Luckst4r/OpenSourcedMiners/LuckyMinerLV08/BM1366_mode1_sheet_1.kicad_sch

## KiCad design LuckyMinerLV08/BM1366_mode1_sheet_1.kicad_sch (2025-10-28)

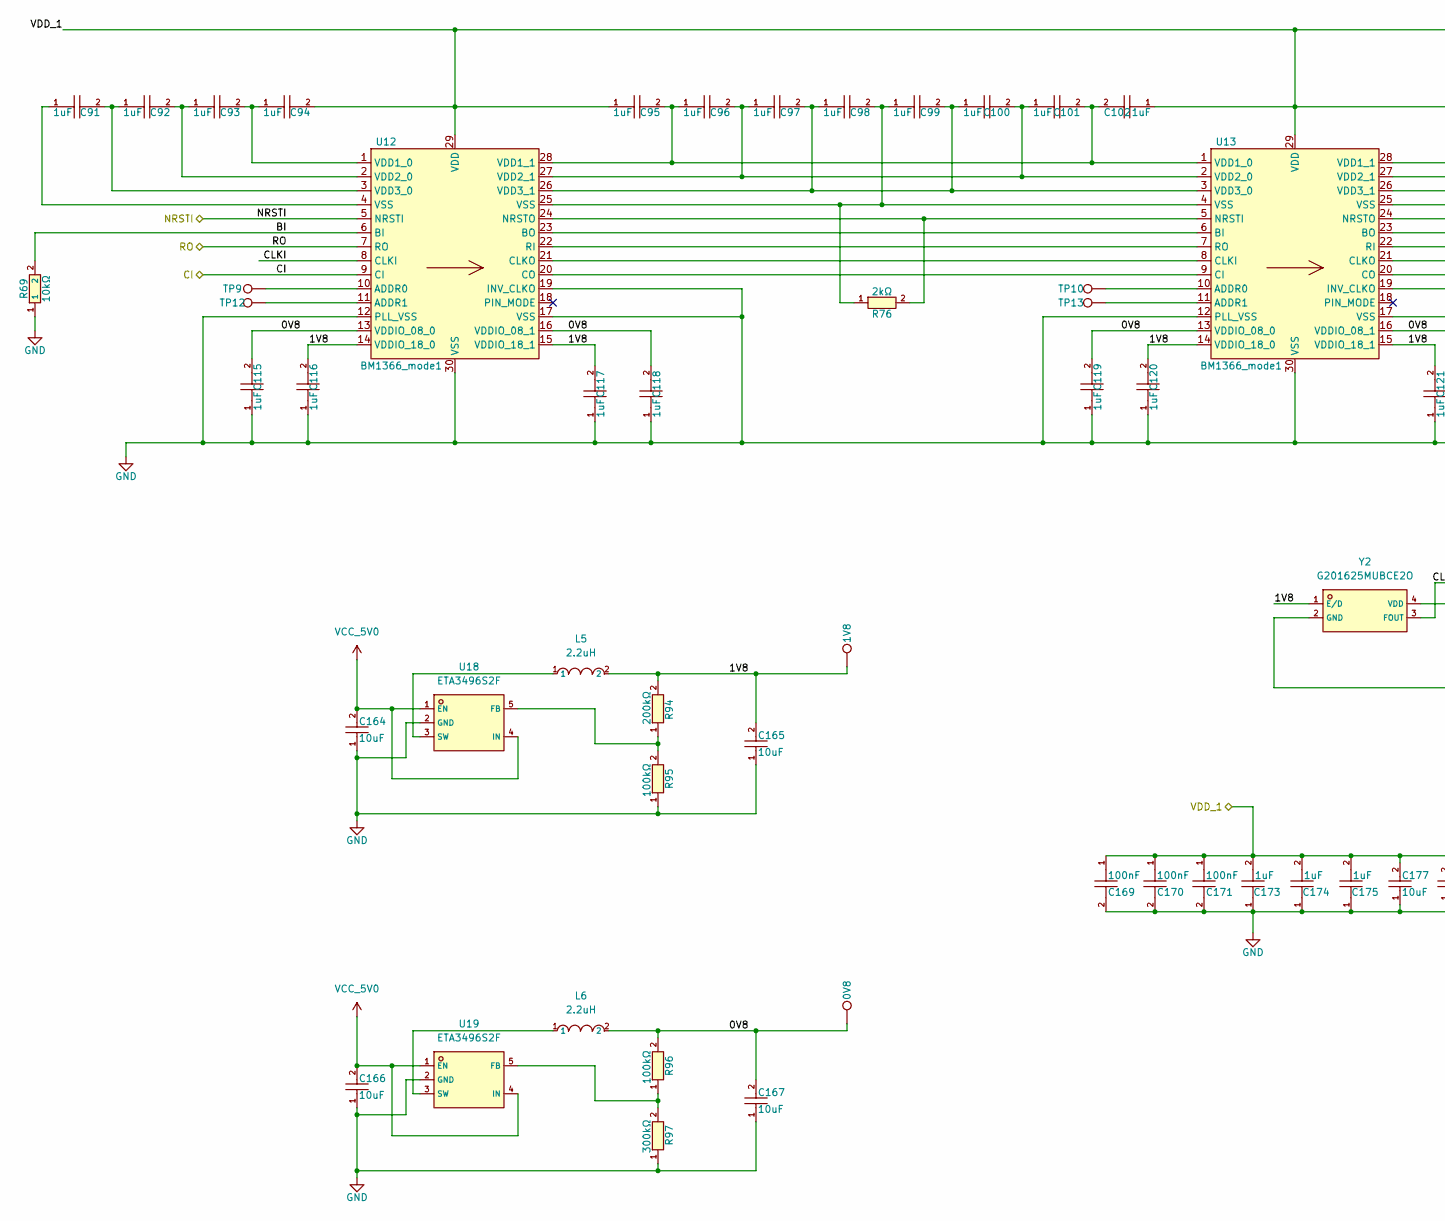
[picture p1: schematic BM1366_mode1_sheet_1.kicad_sch, part in row 1, column 1]

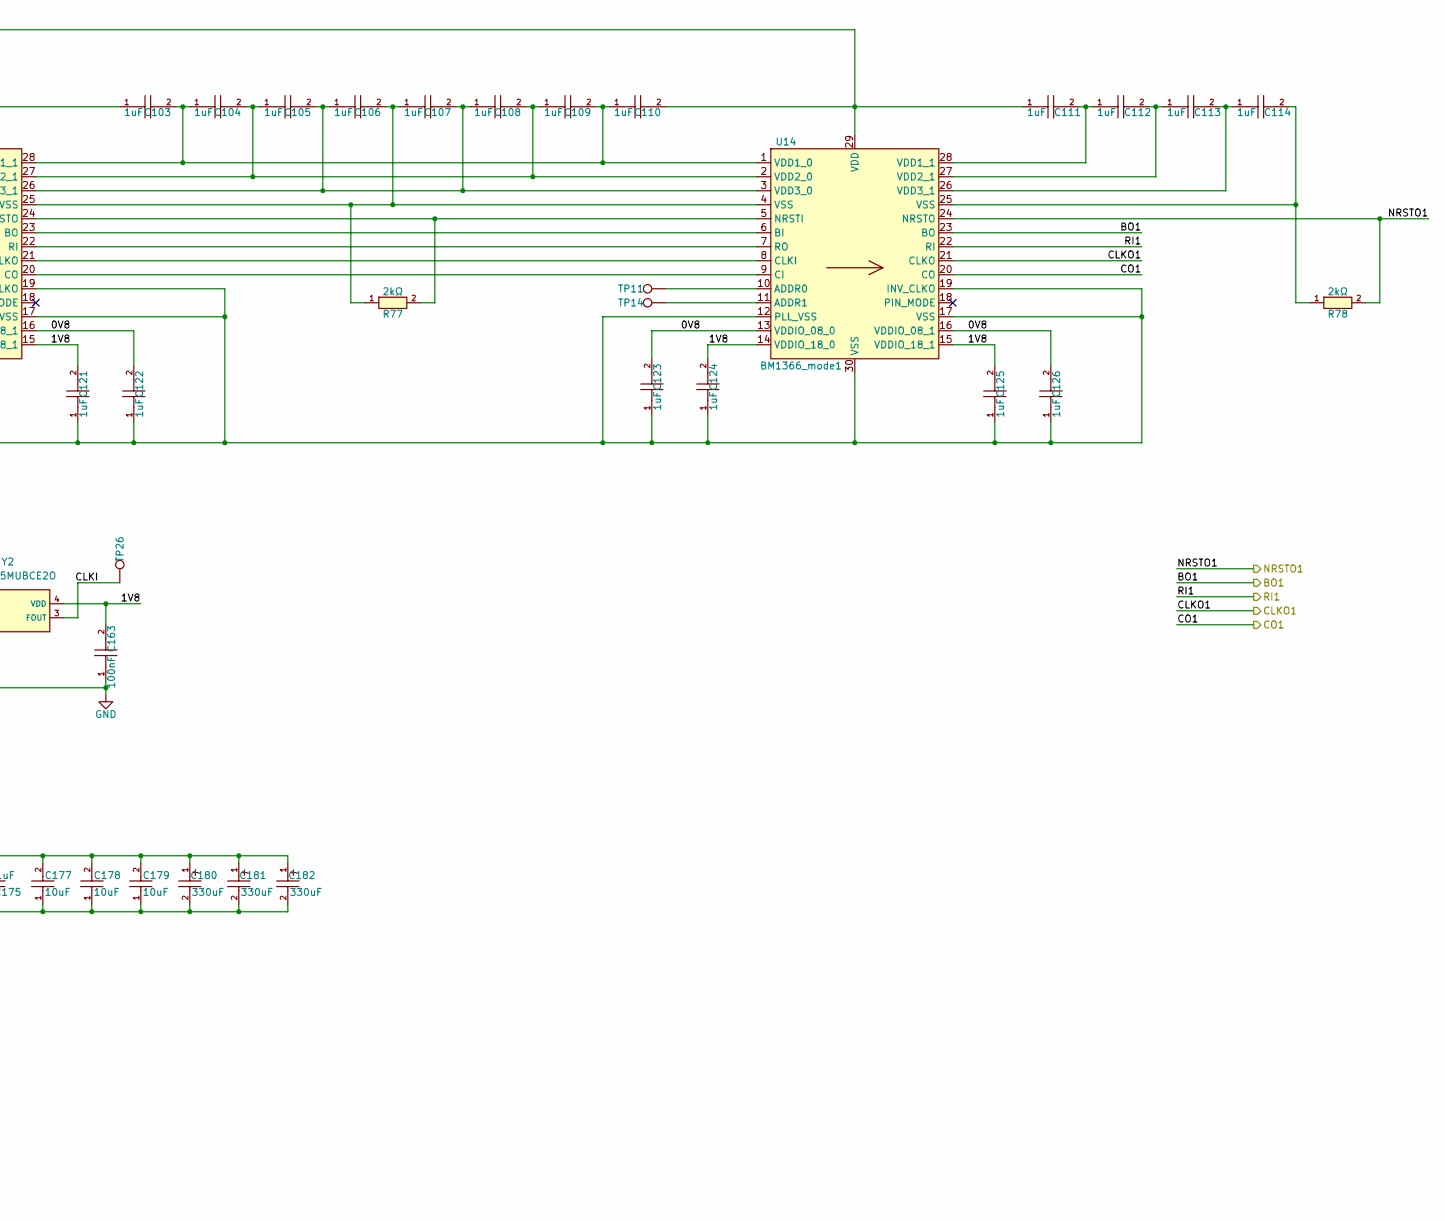
[picture p2: schematic BM1366_mode1_sheet_1.kicad_sch, part in row 1, column 2]

Parts:
0V8, 1V8: TestPoint; TestPoint_Pad_D1.0mm
C91, C92, C93, C94, C95, C96, C97, C98, C99, C100, C101, C102, C103, C104, C105, C106, C107, C108, C109, C110, C111, C112, C113, C114, C115, C116, C117, C118, C119, C120, C121, C122, C123, C124, C125, C126, C173, C174, C175: 1uF; C0402; LCSC C52923
C163, C169, C170, C171: 100nF; C0402; LCSC C307331
C164, C165, C166, C167, C177, C178, C179: 10uF; C0402; LCSC C15525
C180, C181, C182: 330uF; CASE-D_7343; LCSC C7226
L5, L6: 2.2uH; L0805; LCSC C1043
R69: 10kΩ; R0402; LCSC C25744
R76, R77, R78: 2kΩ; R0402; LCSC C4109
R94: 200kΩ; R0402; LCSC C25764
R95, R96: 100kΩ; R0402; LCSC C25741
R97: 300kΩ; R0402; LCSC C25774
TP9, TP10, TP11, TP12, TP13, TP14, TP26: TestPoint; TestPoint_Pad_D1.0mm
U12, U13, U14: BM1366_mode1; BM1366
U18, U19: ETA3496S2F; SOT-23-5_L2.9-W1.6-P0.95-LS2.8-BR; LCSC C7465505
Y2: G201625MUBCE2O; CRYSTAL-SMD_4P-L2.0-W1.6-BL-1; LCSC C41399445

Connections:
0V8: 0V8.1, C115.2, C118.2, C119.2, C122.2, C123.2, C126.2, C167.2, L6.2, R96.2, U12.13 (VDDIO_08_0), U12.16 (VDDIO_08_1), U13.13 (VDDIO_08_0), U13.16 (VDDIO_08_1), U14.13 (VDDIO_08_0), U14.16 (VDDIO_08_1)
1V8: 1V8.1, C116.2, C117.2, C120.2, C121.2, C124.2, C125.2, C163.2, C165.2, L5.2, R94.2, U12.14 (VDDIO_18_0), U12.15 (VDDIO_18_1), U13.14 (VDDIO_18_0), U13.15 (VDDIO_18_1), U14.14 (VDDIO_18_0), U14.15 (VDDIO_18_1), Y2.1 (E/D), Y2.4 (VDD)
BI: R69.2, U12.6 (BI)
BO1: U14.23 (BO)
CI: U12.9 (CI)
CLKI: TP26.1, U12.8 (CLKI), Y2.3 (FOUT)
CLKO1: U14.21 (CLKO)
CO1: U14.20 (CO)
GND: C115.1, C116.1, C117.1, C118.1, C119.1, C120.1, C121.1, C122.1, C123.1, C124.1, C125.1, C126.1, C163.1, C164.1, C165.1, C166.1, C167.1, C169.2, C170.2, C171.2, C173.1, C174.1, C175.1, C177.1, C178.1, C179.1, C180.2, C181.2, C182.2, R69.1, R95.1, R97.1, U12.12 (PLL_VSS), U12.17 (VSS), U12.19 (INV_CLKO), U12.30 (VSS), U13.12 (PLL_VSS), U13.17 (VSS), U13.19 (INV_CLKO), U13.30 (VSS), U14.12 (PLL_VSS), U14.17 (VSS), U14.19 (INV_CLKO), U14.30 (VSS), U18.2 (GND), U19.2 (GND), Y2.2 (GND)
NRSTI: U12.5 (NRSTI)
NRSTO1: R78.2, U14.24 (NRSTO)
unnamed: C91.1, U12.4 (VSS)
unnamed: C91.2, C92.1, U12.3 (VDD3_0)
unnamed: C92.2, C93.1, U12.2 (VDD2_0)
unnamed: C93.2, C94.1, U12.1 (VDD1_0)
unnamed: C98.2, C99.1, R76.1, U12.25 (VSS), U13.4 (VSS)
unnamed: C97.2, C98.1, C99.2, C100.1, U12.26 (VDD3_1), U13.3 (VDD3_0)
unnamed: C96.2, C97.1, C100.2, C101.1, U12.27 (VDD2_1), U13.2 (VDD2_0)
unnamed: C95.2, C96.1, C101.2, C102.2, U12.28 (VDD1_1), U13.1 (VDD1_0)
unnamed: C103.2, C104.1, C109.2, C110.1, U13.28 (VDD1_1), U14.1 (VDD1_0)
unnamed: C104.2, C105.1, C108.2, C109.1, U13.27 (VDD2_1), U14.2 (VDD2_0)
unnamed: C105.2, C106.1, C107.2, C108.1, U13.26 (VDD3_1), U14.3 (VDD3_0)
unnamed: C106.2, C107.1, R77.1, U13.25 (VSS), U14.4 (VSS)
unnamed: C111.2, C112.1, U14.28 (VDD1_1)
unnamed: C112.2, C113.1, U14.27 (VDD2_1)
unnamed: C113.2, C114.1, U14.26 (VDD3_1)
unnamed: C114.2, R78.1, U14.25 (VSS)
unnamed: L5.1, U18.3 (SW)
unnamed: L6.1, U19.3 (SW)
unnamed: R76.2, U12.24 (NRSTO), U13.5 (NRSTI)
unnamed: R77.2, U13.24 (NRSTO), U14.5 (NRSTI)
unnamed: R94.1, R95.2, U18.5 (FB)
unnamed: R96.1, R97.2, U19.5 (FB)
unnamed: TP9.1, U12.10 (ADDR0)
unnamed: TP10.1, U13.10 (ADDR0)
unnamed: TP11.1, U14.10 (ADDR0)
unnamed: TP12.1, U12.11 (ADDR1)
unnamed: TP13.1, U13.11 (ADDR1)
unnamed: TP14.1, U14.11 (ADDR1)
unnamed: U12.20 (CO), U13.9 (CI)
unnamed: U12.21 (CLKO), U13.8 (CLKI)
unnamed: U12.22 (RI), U13.7 (RO)
unnamed: U12.23 (BO), U13.6 (BI)
unnamed: U13.20 (CO), U14.9 (CI)
unnamed: U13.21 (CLKO), U14.8 (CLKI)
unnamed: U13.22 (RI), U14.7 (RO)
unnamed: U13.23 (BO), U14.6 (BI)
RI1: U14.22 (RI)
RO: U12.7 (RO)
VCC_5V0: C164.2, C166.2, U18.1 (EN), U18.4 (IN), U19.1 (EN), U19.4 (IN)
VDD_1: C94.2, C95.1, C102.1, C103.1, C110.2, C111.1, C169.1, C170.1, C171.1, C173.2, C174.2, C175.2, C177.2, C178.2, C179.2, C180.1, C181.1, C182.1, U12.29 (VDD), U13.29 (VDD), U14.29 (VDD)
