Luckst4r/OpenSourcedMiners/LuckyMinerLV08/BM1366_mode1_sheet_2.kicad_sch

## KiCad design LuckyMinerLV08/BM1366_mode1_sheet_2.kicad_sch (2025-10-28)

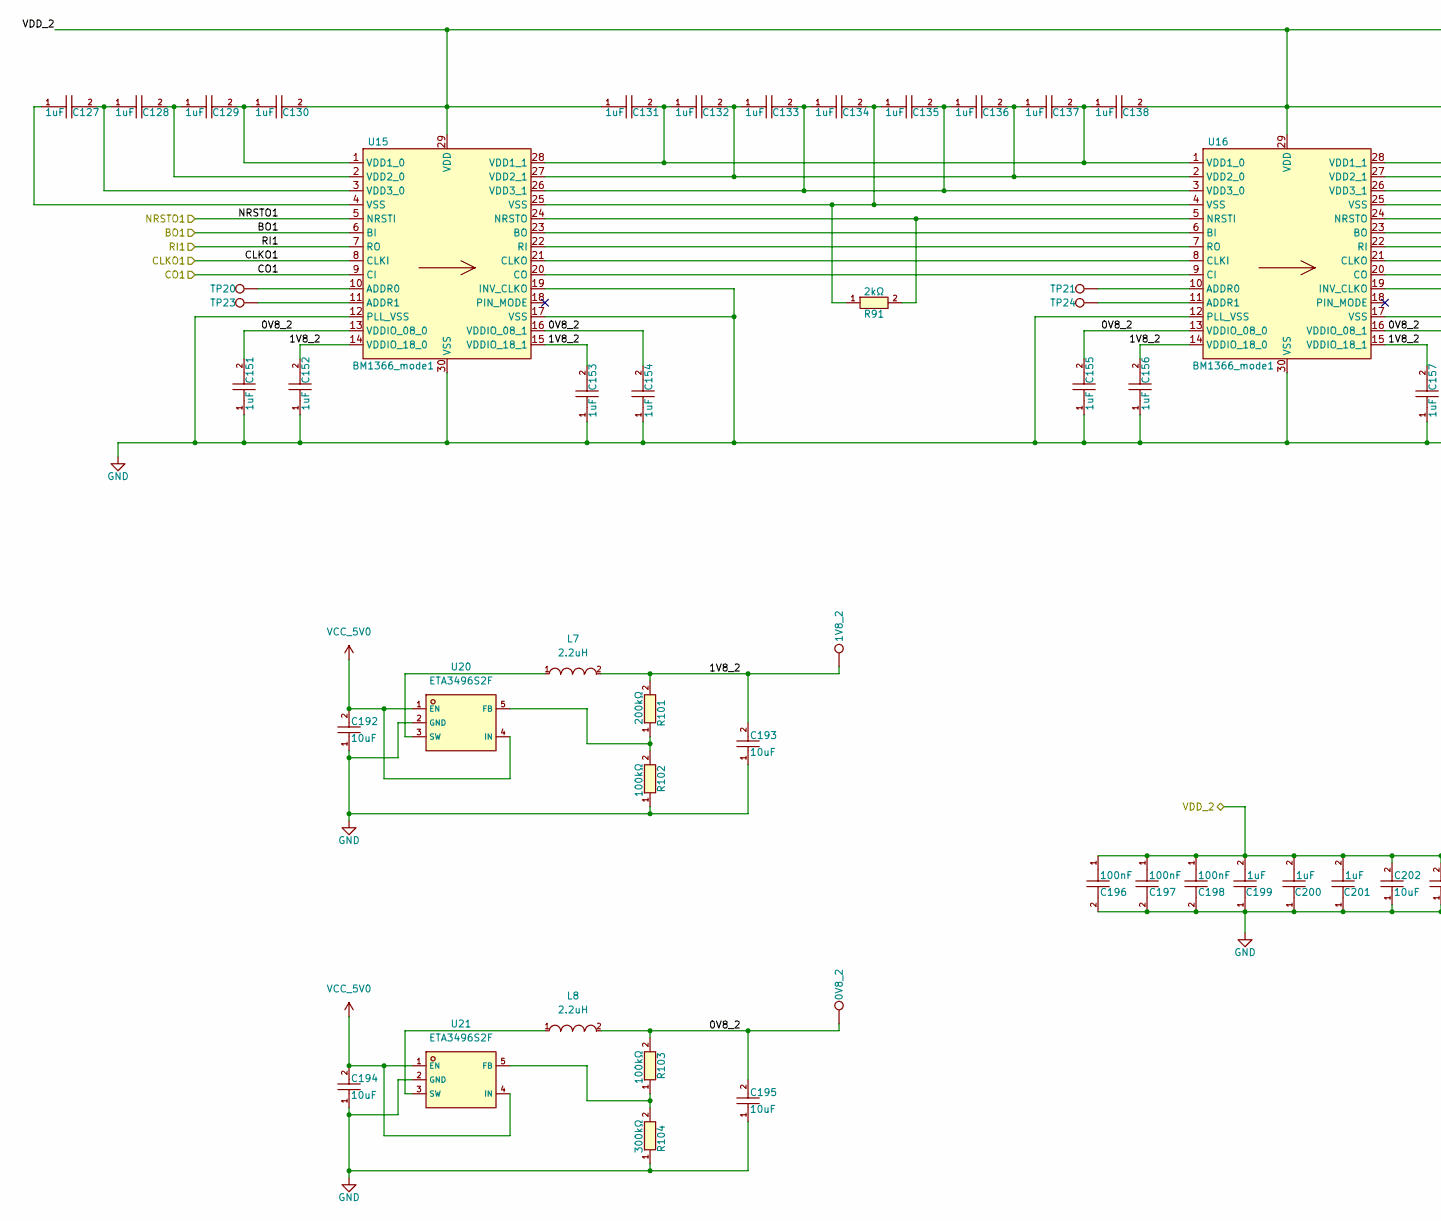
[picture p3: schematic BM1366_mode1_sheet_2.kicad_sch, part in row 1, column 1]

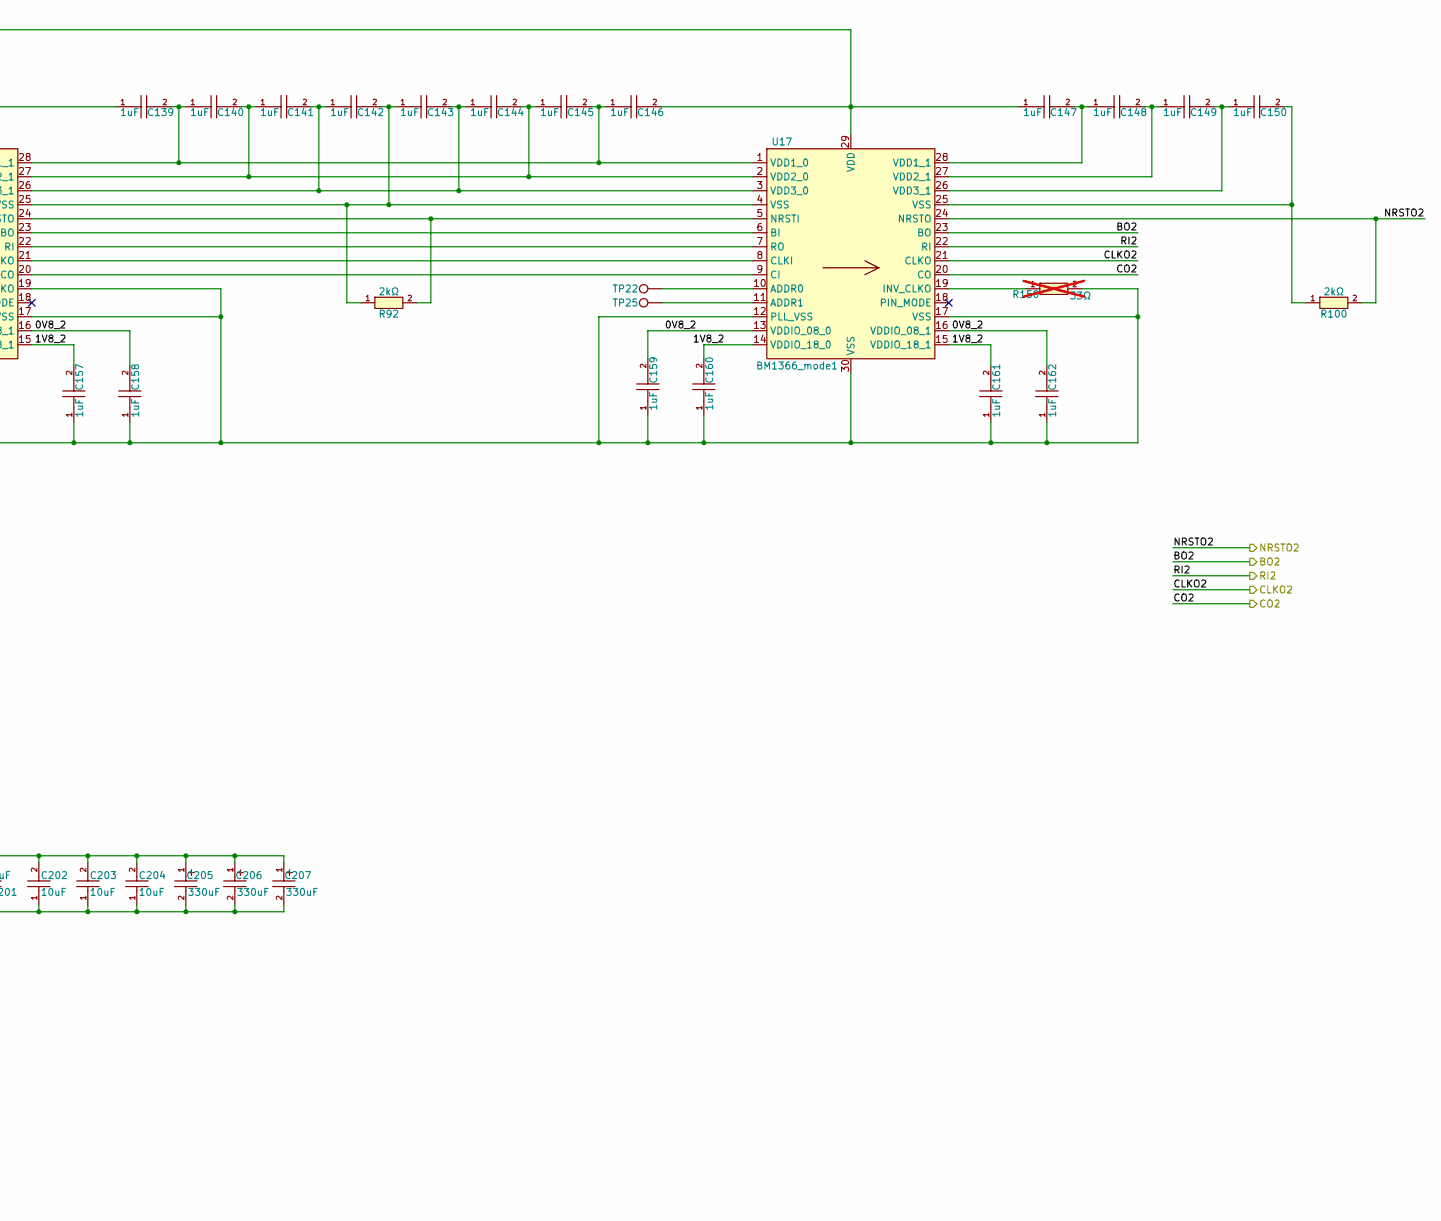
[picture p4: schematic BM1366_mode1_sheet_2.kicad_sch, part in row 1, column 2]

Parts:
0V8_2, 1V8_2: TestPoint; TestPoint_Pad_D1.0mm
C127, C128, C129, C130, C131, C132, C133, C134, C135, C136, C137, C138, C139, C140, C141, C142, C143, C144, C145, C146, C147, C148, C149, C150, C151, C152, C153, C154, C155, C156, C157, C158, C159, C160, C161, C162, C199, C200, C201: 1uF; C0402; LCSC C52923
C192, C193, C194, C195, C202, C203, C204: 10uF; C0402; LCSC C15525
C196, C197, C198: 100nF; C0402; LCSC C307331
C205, C206, C207: 330uF; CASE-D_7343; LCSC C7226
L7, L8: 2.2uH; L0805; LCSC C1043
R91, R92, R100: 2kΩ; R0402; LCSC C4109
R101: 200kΩ; R0402; LCSC C25764
R102, R103: 100kΩ; R0402; LCSC C25741
R104: 300kΩ; R0402; LCSC C25774
R150: 33Ω; R0402; LCSC C25105; not fitted
TP20, TP21, TP22, TP23, TP24, TP25: TestPoint; TestPoint_Pad_D1.0mm
U15, U16, U17: BM1366_mode1; BM1366
U20, U21: ETA3496S2F; SOT-23-5_L2.9-W1.6-P0.95-LS2.8-BR; LCSC C7465505

Connections:
0V8_2: 0V8_2.1, C151.2, C154.2, C155.2, C158.2, C159.2, C162.2, C195.2, L8.2, R103.2, U15.13 (VDDIO_08_0), U15.16 (VDDIO_08_1), U16.13 (VDDIO_08_0), U16.16 (VDDIO_08_1), U17.13 (VDDIO_08_0), U17.16 (VDDIO_08_1)
1V8_2: 1V8_2.1, C152.2, C153.2, C156.2, C157.2, C160.2, C161.2, C193.2, L7.2, R101.2, U15.14 (VDDIO_18_0), U15.15 (VDDIO_18_1), U16.14 (VDDIO_18_0), U16.15 (VDDIO_18_1), U17.14 (VDDIO_18_0), U17.15 (VDDIO_18_1)
BO1: U15.6 (BI)
BO2: U17.23 (BO)
CLKO1: U15.8 (CLKI)
CLKO2: U17.21 (CLKO)
CO1: U15.9 (CI)
CO2: U17.20 (CO)
GND: C151.1, C152.1, C153.1, C154.1, C155.1, C156.1, C157.1, C158.1, C159.1, C160.1, C161.1, C162.1, C192.1, C193.1, C194.1, C195.1, C196.2, C197.2, C198.2, C199.1, C200.1, C201.1, C202.1, C203.1, C204.1, C205.2, C206.2, C207.2, R102.1, R104.1, R150.2, U15.12 (PLL_VSS), U15.17 (VSS), U15.19 (INV_CLKO), U15.30 (VSS), U16.12 (PLL_VSS), U16.17 (VSS), U16.19 (INV_CLKO), U16.30 (VSS), U17.12 (PLL_VSS), U17.17 (VSS), U17.30 (VSS), U20.2 (GND), U21.2 (GND)
NRSTO1: U15.5 (NRSTI)
NRSTO2: R100.2, U17.24 (NRSTO)
unnamed: C127.1, U15.4 (VSS)
unnamed: C127.2, C128.1, U15.3 (VDD3_0)
unnamed: C128.2, C129.1, U15.2 (VDD2_0)
unnamed: C129.2, C130.1, U15.1 (VDD1_0)
unnamed: C131.2, C132.1, C137.2, C138.1, U15.28 (VDD1_1), U16.1 (VDD1_0)
unnamed: C132.2, C133.1, C136.2, C137.1, U15.27 (VDD2_1), U16.2 (VDD2_0)
unnamed: C133.2, C134.1, C135.2, C136.1, U15.26 (VDD3_1), U16.3 (VDD3_0)
unnamed: C134.2, C135.1, R91.1, U15.25 (VSS), U16.4 (VSS)
unnamed: C139.2, C140.1, C145.2, C146.1, U16.28 (VDD1_1), U17.1 (VDD1_0)
unnamed: C140.2, C141.1, C144.2, C145.1, U16.27 (VDD2_1), U17.2 (VDD2_0)
unnamed: C141.2, C142.1, C143.2, C144.1, U16.26 (VDD3_1), U17.3 (VDD3_0)
unnamed: C142.2, C143.1, R92.1, U16.25 (VSS), U17.4 (VSS)
unnamed: C147.2, C148.1, U17.28 (VDD1_1)
unnamed: C148.2, C149.1, U17.27 (VDD2_1)
unnamed: C149.2, C150.1, U17.26 (VDD3_1)
unnamed: C150.2, R100.1, U17.25 (VSS)
unnamed: L7.1, U20.3 (SW)
unnamed: L8.1, U21.3 (SW)
unnamed: R91.2, U15.24 (NRSTO), U16.5 (NRSTI)
unnamed: R92.2, U16.24 (NRSTO), U17.5 (NRSTI)
unnamed: R101.1, R102.2, U20.5 (FB)
unnamed: R103.1, R104.2, U21.5 (FB)
unnamed: R150.1, U17.19 (INV_CLKO)
unnamed: TP20.1, U15.10 (ADDR0)
unnamed: TP21.1, U16.10 (ADDR0)
unnamed: TP22.1, U17.10 (ADDR0)
unnamed: TP23.1, U15.11 (ADDR1)
unnamed: TP24.1, U16.11 (ADDR1)
unnamed: TP25.1, U17.11 (ADDR1)
unnamed: U15.20 (CO), U16.9 (CI)
unnamed: U15.21 (CLKO), U16.8 (CLKI)
unnamed: U15.22 (RI), U16.7 (RO)
unnamed: U15.23 (BO), U16.6 (BI)
unnamed: U16.20 (CO), U17.9 (CI)
unnamed: U16.21 (CLKO), U17.8 (CLKI)
unnamed: U16.22 (RI), U17.7 (RO)
unnamed: U16.23 (BO), U17.6 (BI)
RI1: U15.7 (RO)
RI2: U17.22 (RI)
VCC_5V0: C192.2, C194.2, U20.1 (EN), U20.4 (IN), U21.1 (EN), U21.4 (IN)
VDD_2: C130.2, C131.1, C138.2, C139.1, C146.2, C147.1, C196.1, C197.1, C198.1, C199.2, C200.2, C201.2, C202.2, C203.2, C204.2, C205.1, C206.1, C207.1, U15.29 (VDD), U16.29 (VDD), U17.29 (VDD)
