Luckst4r/OpenSourcedMiners/LuckyMinerLV08/BM1366_mode1_sheet_3.kicad_sch

## KiCad design LuckyMinerLV08/BM1366_mode1_sheet_3.kicad_sch (2025-10-28)

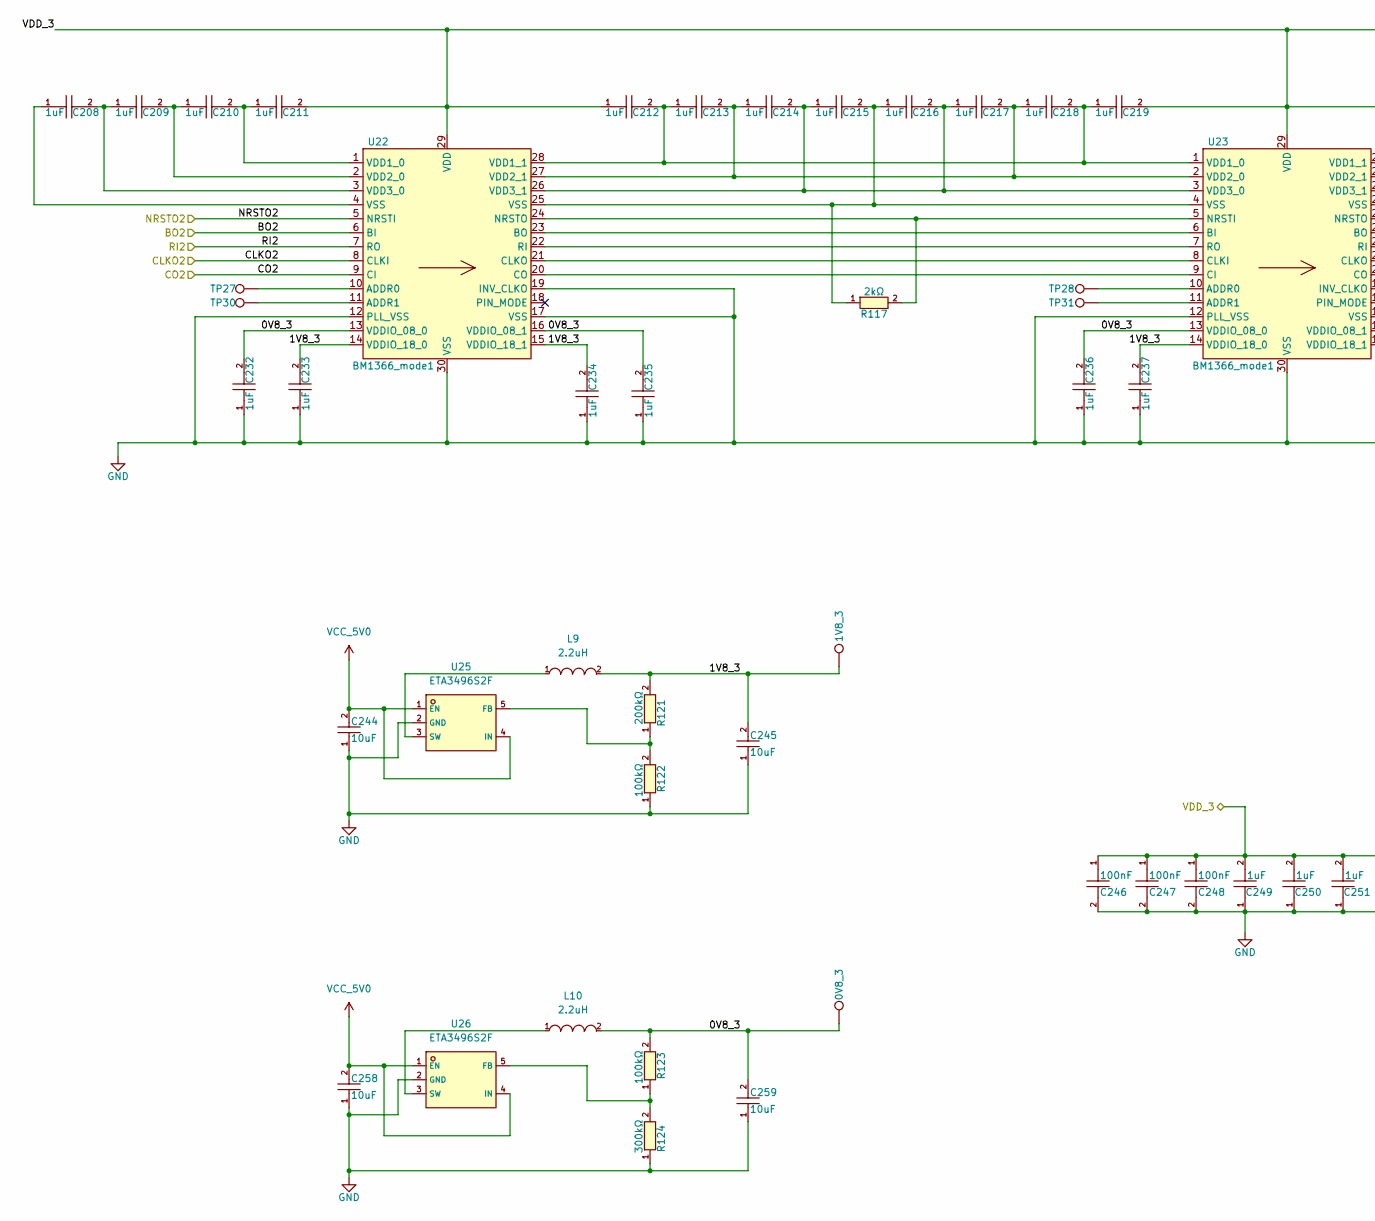
[picture p5: schematic BM1366_mode1_sheet_3.kicad_sch, part in row 1, column 1]

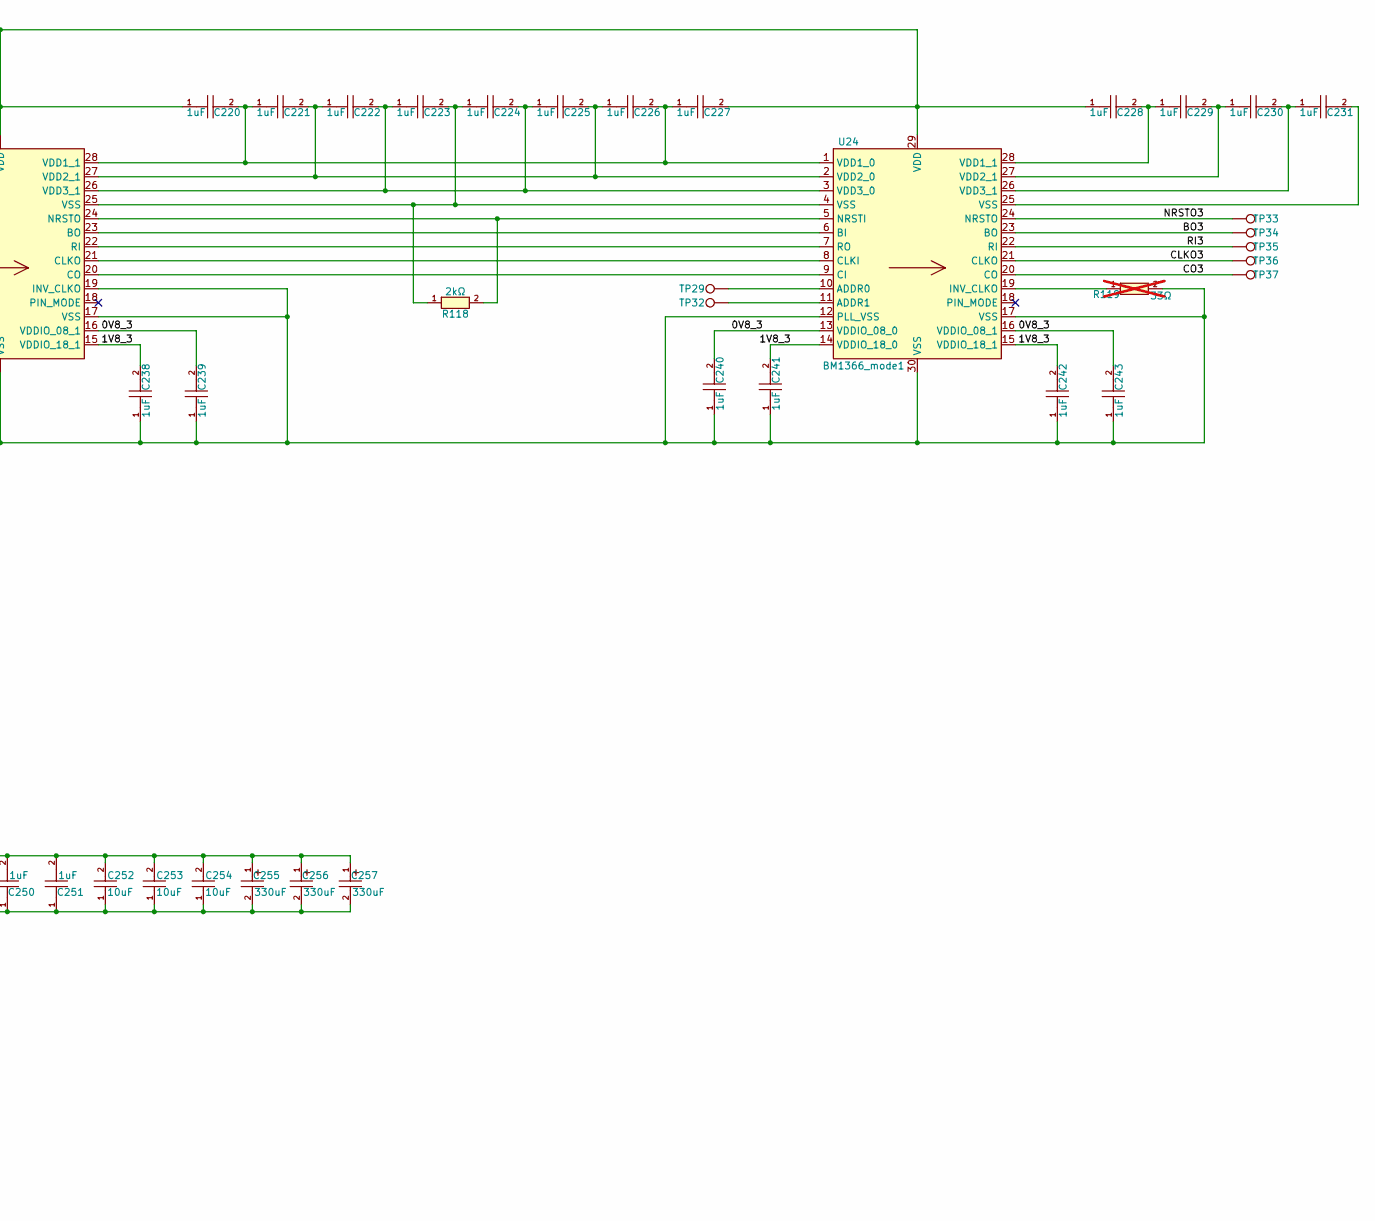
[picture p6: schematic BM1366_mode1_sheet_3.kicad_sch, part in row 1, column 2]

Parts:
0V8_3, 1V8_3: TestPoint; TestPoint_Pad_D1.0mm
C208, C209, C210, C211, C212, C213, C214, C215, C216, C217, C218, C219, C220, C221, C222, C223, C224, C225, C226, C227, C228, C229, C230, C231, C232, C233, C234, C235, C236, C237, C238, C239, C240, C241, C242, C243, C249, C250, C251: 1uF; C0402; LCSC C52923
C244, C245, C252, C253, C254, C258, C259: 10uF; C0402; LCSC C15525
C246, C247, C248: 100nF; C0402; LCSC C307331
C255, C256, C257: 330uF; CASE-D_7343; LCSC C7226
L9, L10: 2.2uH; L0805; LCSC C1043
R117, R118: 2kΩ; R0402; LCSC C4109
R119: 33Ω; R0402; LCSC C25105; not fitted
R121: 200kΩ; R0402; LCSC C25764
R122, R123: 100kΩ; R0402; LCSC C25741
R124: 300kΩ; R0402; LCSC C25774
TP27, TP28, TP29, TP30, TP31, TP32, TP33, TP34, TP35, TP36, TP37: TestPoint; TestPoint_Pad_D1.0mm
U22, U23, U24: BM1366_mode1; BM1366
U25, U26: ETA3496S2F; SOT-23-5_L2.9-W1.6-P0.95-LS2.8-BR; LCSC C7465505

Connections:
0V8_3: 0V8_3.1, C232.2, C235.2, C236.2, C239.2, C240.2, C243.2, C259.2, L10.2, R123.2, U22.13 (VDDIO_08_0), U22.16 (VDDIO_08_1), U23.13 (VDDIO_08_0), U23.16 (VDDIO_08_1), U24.13 (VDDIO_08_0), U24.16 (VDDIO_08_1)
1V8_3: 1V8_3.1, C233.2, C234.2, C237.2, C238.2, C241.2, C242.2, C245.2, L9.2, R121.2, U22.14 (VDDIO_18_0), U22.15 (VDDIO_18_1), U23.14 (VDDIO_18_0), U23.15 (VDDIO_18_1), U24.14 (VDDIO_18_0), U24.15 (VDDIO_18_1)
BO2: U22.6 (BI)
BO3: TP34.1, U24.23 (BO)
CLKO2: U22.8 (CLKI)
CLKO3: TP36.1, U24.21 (CLKO)
CO2: U22.9 (CI)
CO3: TP37.1, U24.20 (CO)
GND: C232.1, C233.1, C234.1, C235.1, C236.1, C237.1, C238.1, C239.1, C240.1, C241.1, C242.1, C243.1, C244.1, C245.1, C246.2, C247.2, C248.2, C249.1, C250.1, C251.1, C252.1, C253.1, C254.1, C255.2, C256.2, C257.2, C258.1, C259.1, R119.2, R122.1, R124.1, U22.12 (PLL_VSS), U22.17 (VSS), U22.19 (INV_CLKO), U22.30 (VSS), U23.12 (PLL_VSS), U23.17 (VSS), U23.19 (INV_CLKO), U23.30 (VSS), U24.12 (PLL_VSS), U24.17 (VSS), U24.30 (VSS), U25.2 (GND), U26.2 (GND)
NRSTO2: U22.5 (NRSTI)
NRSTO3: TP33.1, U24.24 (NRSTO)
unnamed: C208.1, U22.4 (VSS)
unnamed: C208.2, C209.1, U22.3 (VDD3_0)
unnamed: C209.2, C210.1, U22.2 (VDD2_0)
unnamed: C210.2, C211.1, U22.1 (VDD1_0)
unnamed: C212.2, C213.1, C218.2, C219.1, U22.28 (VDD1_1), U23.1 (VDD1_0)
unnamed: C213.2, C214.1, C217.2, C218.1, U22.27 (VDD2_1), U23.2 (VDD2_0)
unnamed: C214.2, C215.1, C216.2, C217.1, U22.26 (VDD3_1), U23.3 (VDD3_0)
unnamed: C215.2, C216.1, R117.1, U22.25 (VSS), U23.4 (VSS)
unnamed: C220.2, C221.1, C226.2, C227.1, U23.28 (VDD1_1), U24.1 (VDD1_0)
unnamed: C221.2, C222.1, C225.2, C226.1, U23.27 (VDD2_1), U24.2 (VDD2_0)
unnamed: C222.2, C223.1, C224.2, C225.1, U23.26 (VDD3_1), U24.3 (VDD3_0)
unnamed: C223.2, C224.1, R118.1, U23.25 (VSS), U24.4 (VSS)
unnamed: C228.2, C229.1, U24.28 (VDD1_1)
unnamed: C229.2, C230.1, U24.27 (VDD2_1)
unnamed: C230.2, C231.1, U24.26 (VDD3_1)
unnamed: C231.2, U24.25 (VSS)
unnamed: L9.1, U25.3 (SW)
unnamed: L10.1, U26.3 (SW)
unnamed: R117.2, U22.24 (NRSTO), U23.5 (NRSTI)
unnamed: R118.2, U23.24 (NRSTO), U24.5 (NRSTI)
unnamed: R119.1, U24.19 (INV_CLKO)
unnamed: R121.1, R122.2, U25.5 (FB)
unnamed: R123.1, R124.2, U26.5 (FB)
unnamed: TP27.1, U22.10 (ADDR0)
unnamed: TP28.1, U23.10 (ADDR0)
unnamed: TP29.1, U24.10 (ADDR0)
unnamed: TP30.1, U22.11 (ADDR1)
unnamed: TP31.1, U23.11 (ADDR1)
unnamed: TP32.1, U24.11 (ADDR1)
unnamed: U22.20 (CO), U23.9 (CI)
unnamed: U22.21 (CLKO), U23.8 (CLKI)
unnamed: U22.22 (RI), U23.7 (RO)
unnamed: U22.23 (BO), U23.6 (BI)
unnamed: U23.20 (CO), U24.9 (CI)
unnamed: U23.21 (CLKO), U24.8 (CLKI)
unnamed: U23.22 (RI), U24.7 (RO)
unnamed: U23.23 (BO), U24.6 (BI)
RI2: U22.7 (RO)
RI3: TP35.1, U24.22 (RI)
VCC_5V0: C244.2, C258.2, U25.1 (EN), U25.4 (IN), U26.1 (EN), U26.4 (IN)
VDD_3: C211.2, C212.1, C219.2, C220.1, C227.2, C228.1, C246.1, C247.1, C248.1, C249.2, C250.2, C251.2, C252.2, C253.2, C254.2, C255.1, C256.1, C257.1, U22.29 (VDD), U23.29 (VDD), U24.29 (VDD)
