Luckst4r/OpenSourcedMiners/LuckyMinerLV08/Buck_Converters_TPS546D24ARVFR.kicad_sch

## KiCad design LuckyMinerLV08/Buck_Converters_TPS546D24ARVFR.kicad_sch (2025-10-28)

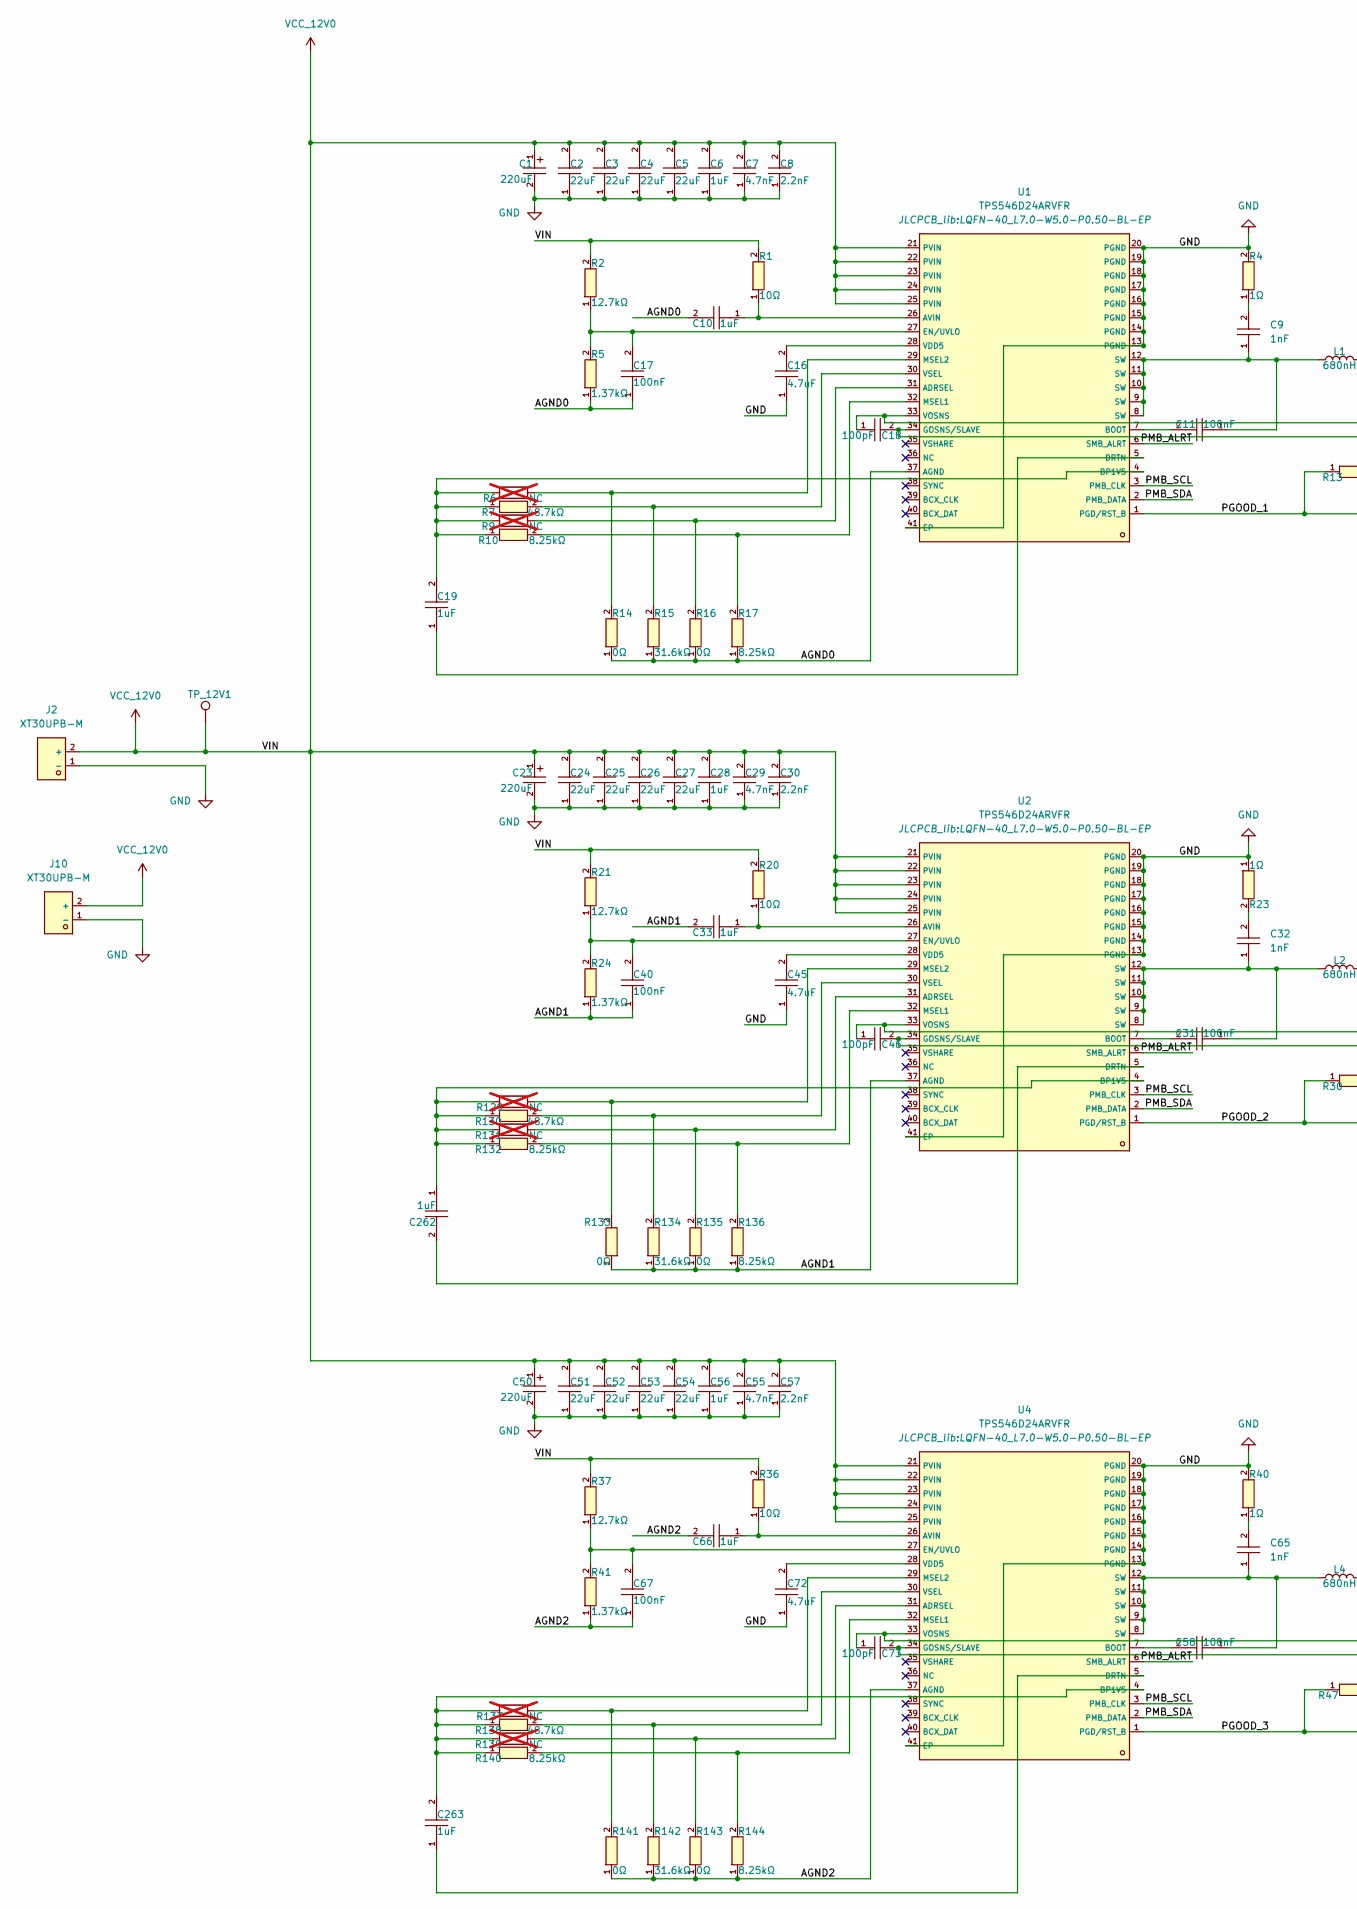
[picture p7: schematic Buck_Converters_TPS546D24ARVFR.kicad_sch, part in row 1, column 1]

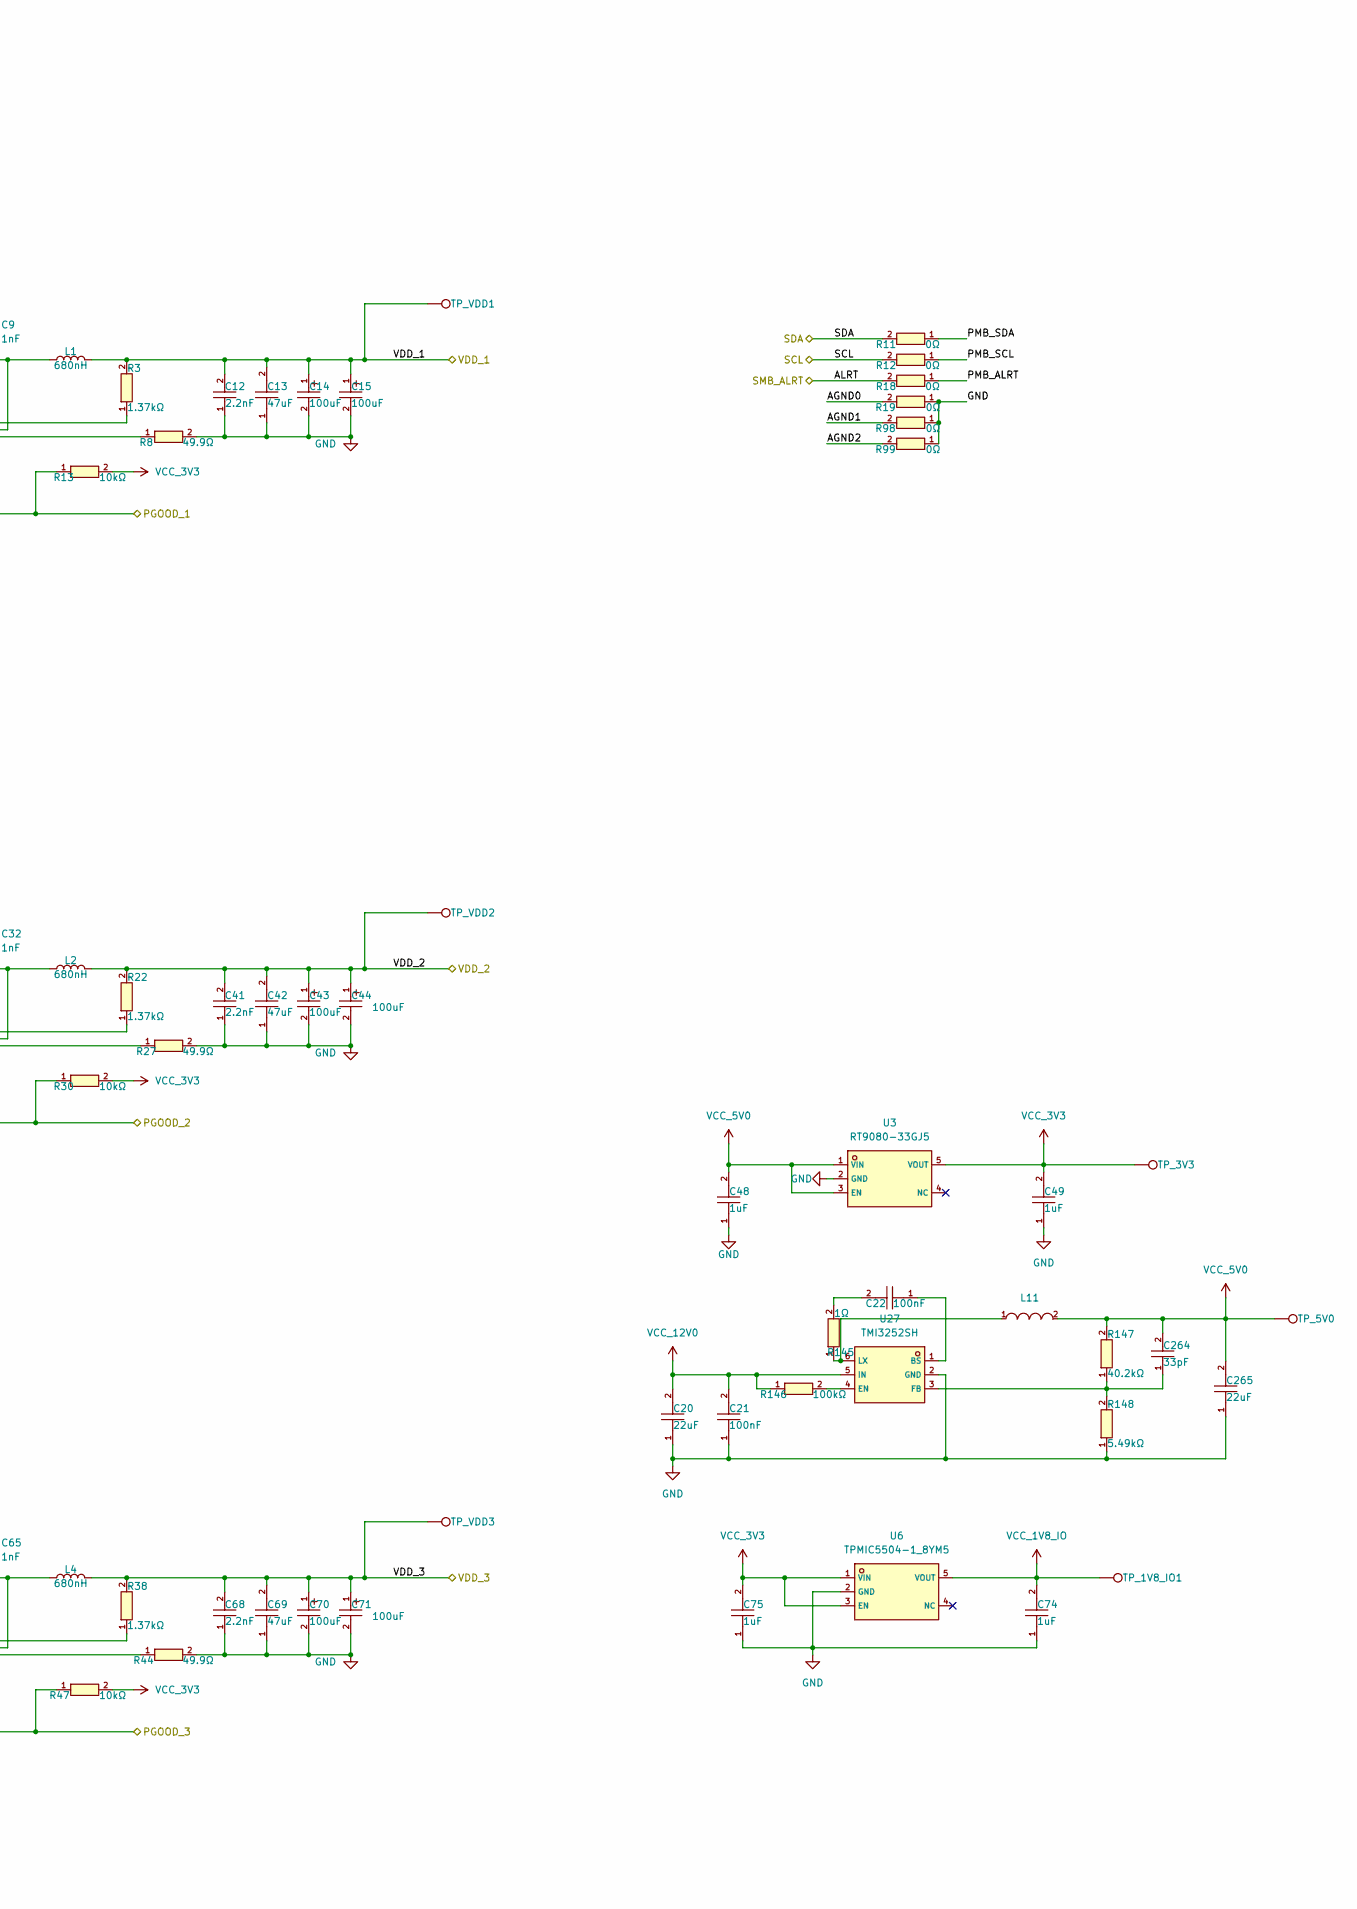
[picture p8: schematic Buck_Converters_TPS546D24ARVFR.kicad_sch, part in row 1, column 2]

Parts:
C1, C23, C50: 220uF; CAP-SMD_BD6.3-L6.6-W6.6-FD; LCSC C3342
C2, C3, C4, C5, C20, C24, C25, C26, C27, C51, C52, C53, C54, C265: 22uF; C0805; LCSC C45783
C6, C10, C19, C28, C33, C48, C49, C56, C66, C74, C75, C262, C263: 1uF; C0402; LCSC C52923
C7, C29, C55: 4.7nF; C0402; LCSC C1538
C8, C12, C30, C41, C57, C68: 2.2nF; C0402; LCSC C1531
C9, C32, C65: 1nF; C0402; LCSC C1523
C11, C17, C21, C22, C31, C40, C58, C67: 100nF; C0402; LCSC C307331
C13, C42, C69: 47uF; C1206; LCSC C96123
C14, C15, C43, C44, C70, C71: 100uF; CASE-B_3528; LCSC C7196
C16, C45, C72: 4.7uF; C0603; LCSC C19666
C18, C46, C73: 100pF; C0402; LCSC C1546
C264: 33pF; C0402; LCSC C1562
J2, J10: XT30UPB-M; CONN-TH_XT30UPB-M; LCSC C428721
L1, L2, L4: 680nH; IND-SMD_L17.2-W17.2; Mouser P/N 70-IHLP6767DZERR68M0; LCSC C5656947
L11: SWPA4030S3R3MT; IND-SMD_L4.0-W4.0_SMNR4012; LCSC C15269
R1, R20, R36: 10Ω; R0402; LCSC C25077
R2, R21, R37: 12.7kΩ; R0402; LCSC C25853
R3, R5, R22, R24, R38, R41: 1.37kΩ; R0402; LCSC C226849
R4, R23, R40, R145: 1Ω; R0402; LCSC C25086
R6, R9, R129, R131, R137, R139: NC; R0402; not fitted
R7, R130, R138: 48.7kΩ; R0402; LCSC C26981
R8, R27, R44: 49.9Ω; R0402; LCSC C25120
R10, R17, R132, R136, R140, R144: 8.25kΩ; R0402; LCSC C95598
R11, R12, R14, R16, R18, R133, R135, R141, R143: 0Ω; R0402; LCSC C17168
R13, R30, R47: 10kΩ; R0402; LCSC C25744
R15, R134, R142: 31.6kΩ; R0402; LCSC C11463
R19, R98, R99: 0Ω; R0805; LCSC C17477
R146: 100kΩ; R0402; LCSC C25741
R147: 40.2kΩ; R0603; LCSC C12447
R148: 5.49kΩ; R0402; LCSC C11628
TP_1V8_IO1, TP_3V3, TP_5V0, TP_12V1: TestPoint; TestPoint_Pad_D1.0mm
TP_VDD1, TP_VDD2, TP_VDD3: TestPoint; TestPoint_Pad_D1.0mm
U1, U2, U4: TPS546D24ARVFR; LQFN-40_L7.0-W5.0-P0.50-BL-EP; LCSC C507280
U3: RT9080-33GJ5; TSOT-23-5_L2.9-W1.6-P0.95-LS2.8-BL; LCSC C841192
U6: TPMIC5504-1_8YM5; SOT-23-5_L3.0-W1.5-P0.95-LS2.8-BL; LCSC C3040643
U27: TMI3252SH; SOT-23-6_L2.9-W1.6-P0.95-LS2.8-BL; LCSC C478947

Connections:
AGND0: C10.2, C17.1, R5.1, R14.1, R15.1, R16.1, R17.1, R19.2, U1.37 (AGND)
AGND1: C33.2, C40.1, R24.1, R98.2, R133.1, R134.1, R135.1, R136.1, U2.37 (AGND)
AGND2: C66.2, C67.1, R41.1, R99.2, R141.1, R142.1, R143.1, R144.1, U4.37 (AGND)
ALRT: R18.2
GND: C1.2, C2.1, C3.1, C4.1, C5.1, C6.1, C7.1, C8.1, C12.1, C13.1, C14.2, C15.2, C16.1, C20.1, C21.1, C23.2, C24.1, C25.1, C26.1, C27.1, C28.1, C29.1, C30.1, C41.1, C42.1, C43.2, C44.2, C45.1, C48.1, C49.1, C50.2, C51.1, C52.1, C53.1, C54.1, C55.1, C56.1, C57.1, C68.1, C69.1, C70.2, C71.2, C72.1, C74.1, C75.1, C265.1, J2.1 (-), J10.1 (-), R4.2, R8.2, R19.1, R23.1, R27.2, R40.2, R44.2, R98.1, R99.1, R148.1, U1.13 (PGND), U1.14 (PGND), U1.15 (PGND), U1.16 (PGND), U1.17 (PGND), U1.18 (PGND), U1.19 (PGND), U1.20 (PGND), U1.41 (EP), U2.13 (PGND), U2.14 (PGND), U2.15 (PGND), U2.16 (PGND), U2.17 (PGND), U2.18 (PGND), U2.19 (PGND), U2.20 (PGND), U2.41 (EP), U3.2 (GND), U4.13 (PGND), U4.14 (PGND), U4.15 (PGND), U4.16 (PGND), U4.17 (PGND), U4.18 (PGND), U4.19 (PGND), U4.20 (PGND), U4.41 (EP), U6.2 (GND), U27.2 (GND)
unnamed: C9.2, R4.1
unnamed: C10.1, R1.1, U1.26 (AVIN)
unnamed: C9.1, C11.1, L1.1, U1.8 (SW), U1.9 (SW), U1.10 (SW), U1.11 (SW), U1.12 (SW)
unnamed: C11.2, U1.7 (BOOT)
unnamed: C16.2, U1.28 (VDD5)
unnamed: C17.2, R2.1, R5.2, U1.27 (EN/UVLO)
unnamed: C18.1, R3.1, U1.33 (VOSNS)
unnamed: C18.2, R8.1, U1.34 (GOSNS/SLAVE)
unnamed: C19.1, U1.5 (DRTN)
unnamed: C19.2, R6.1, R7.1, R9.1, R10.1, U1.4 (BP1V5)
unnamed: C22.1, U27.1 (BS)
unnamed: C22.2, R145.2
unnamed: C31.1, C32.1, L2.1, U2.8 (SW), U2.9 (SW), U2.10 (SW), U2.11 (SW), U2.12 (SW)
unnamed: C31.2, U2.7 (BOOT)
unnamed: C32.2, R23.2
unnamed: C33.1, R20.1, U2.26 (AVIN)
unnamed: C40.2, R21.1, R24.2, U2.27 (EN/UVLO)
unnamed: C45.2, U2.28 (VDD5)
unnamed: C46.1, R22.1, U2.33 (VOSNS)
unnamed: C46.2, R27.1, U2.34 (GOSNS/SLAVE)
unnamed: C58.1, C65.1, L4.1, U4.8 (SW), U4.9 (SW), U4.10 (SW), U4.11 (SW), U4.12 (SW)
unnamed: C58.2, U4.7 (BOOT)
unnamed: C65.2, R40.1
unnamed: C66.1, R36.1, U4.26 (AVIN)
unnamed: C67.2, R37.1, R41.2, U4.27 (EN/UVLO)
unnamed: C72.2, U4.28 (VDD5)
unnamed: C73.1, R38.1, U4.33 (VOSNS)
unnamed: C73.2, R44.1, U4.34 (GOSNS/SLAVE)
unnamed: C262.1, R129.1, R130.1, R131.1, R132.1, U2.4 (BP1V5)
unnamed: C262.2, U2.5 (DRTN)
unnamed: C263.1, U4.5 (DRTN)
unnamed: C263.2, R137.1, R138.1, R139.1, R140.1, U4.4 (BP1V5)
unnamed: C264.1, R147.1, R148.2, U27.3 (FB)
unnamed: L11.1, R145.1, U27.6 (LX)
unnamed: R10.2, R17.2, U1.32 (MSEL1)
unnamed: R6.2, R14.2, U1.29 (MSEL2)
unnamed: R7.2, R15.2, U1.30 (VSEL)
unnamed: R9.2, R16.2, U1.31 (ADRSEL)
unnamed: R129.2, R133.2, U2.29 (MSEL2)
unnamed: R130.2, R134.2, U2.30 (VSEL)
unnamed: R131.2, R135.2, U2.31 (ADRSEL)
unnamed: R132.2, R136.2, U2.32 (MSEL1)
unnamed: R137.2, R141.2, U4.29 (MSEL2)
unnamed: R138.2, R142.2, U4.30 (VSEL)
unnamed: R139.2, R143.2, U4.31 (ADRSEL)
unnamed: R140.2, R144.2, U4.32 (MSEL1)
unnamed: R146.2, U27.4 (EN)
PGOOD_1: R13.1, U1.1 (PGD/RST_B)
PGOOD_2: R30.1, U2.1 (PGD/RST_B)
PGOOD_3: R47.1, U4.1 (PGD/RST_B)
PMB_ALRT: R18.1, U1.6 (SMB_ALRT), U2.6 (SMB_ALRT), U4.6 (SMB_ALRT)
PMB_SCL: R12.1, U1.3 (PMB_CLK), U2.3 (PMB_CLK), U4.3 (PMB_CLK)
PMB_SDA: R11.1, U1.2 (PMB_DATA), U2.2 (PMB_DATA), U4.2 (PMB_DATA)
SCL: R12.2
SDA: R11.2
VCC_1V8_IO: C74.2, TP_1V8_IO1.1, U6.5 (VOUT)
VCC_3V3: C49.2, C75.2, R13.2, R30.2, R47.2, TP_3V3.1, U3.5 (VOUT), U6.1 (VIN), U6.3 (EN)
VCC_5V0: C48.2, C264.2, C265.2, L11.2, R147.2, TP_5V0.1, U3.1 (VIN), U3.3 (EN)
VCC_12V0: C1.1, C2.2, C3.2, C4.2, C5.2, C6.2, C7.2, C8.2, C20.2, C21.2, C23.1, C24.2, C25.2, C26.2, C27.2, C28.2, C29.2, C30.2, C50.1, C51.2, C52.2, C53.2, C54.2, C55.2, C56.2, C57.2, J2.2 (+), J10.2 (+), R1.2, R2.2, R20.2, R21.2, R36.2, R37.2, R146.1, TP_12V1.1, U1.21 (PVIN), U1.22 (PVIN), U1.23 (PVIN), U1.24 (PVIN), U1.25 (PVIN), U2.21 (PVIN), U2.22 (PVIN), U2.23 (PVIN), U2.24 (PVIN), U2.25 (PVIN), U4.21 (PVIN), U4.22 (PVIN), U4.23 (PVIN), U4.24 (PVIN), U4.25 (PVIN), U27.5 (IN)
VDD_1: C12.2, C13.2, C14.1, C15.1, L1.2, R3.2, TP_VDD1.1
VDD_2: C41.2, C42.2, C43.1, C44.1, L2.2, R22.2, TP_VDD2.1
VDD_3: C68.2, C69.2, C70.1, C71.1, L4.2, R38.2, TP_VDD3.1
