Luckst4r/OpenSourcedMiners/LuckyMinerLV08/ESP32.kicad_sch

## KiCad design LuckyMinerLV08/ESP32.kicad_sch (2025-10-28)

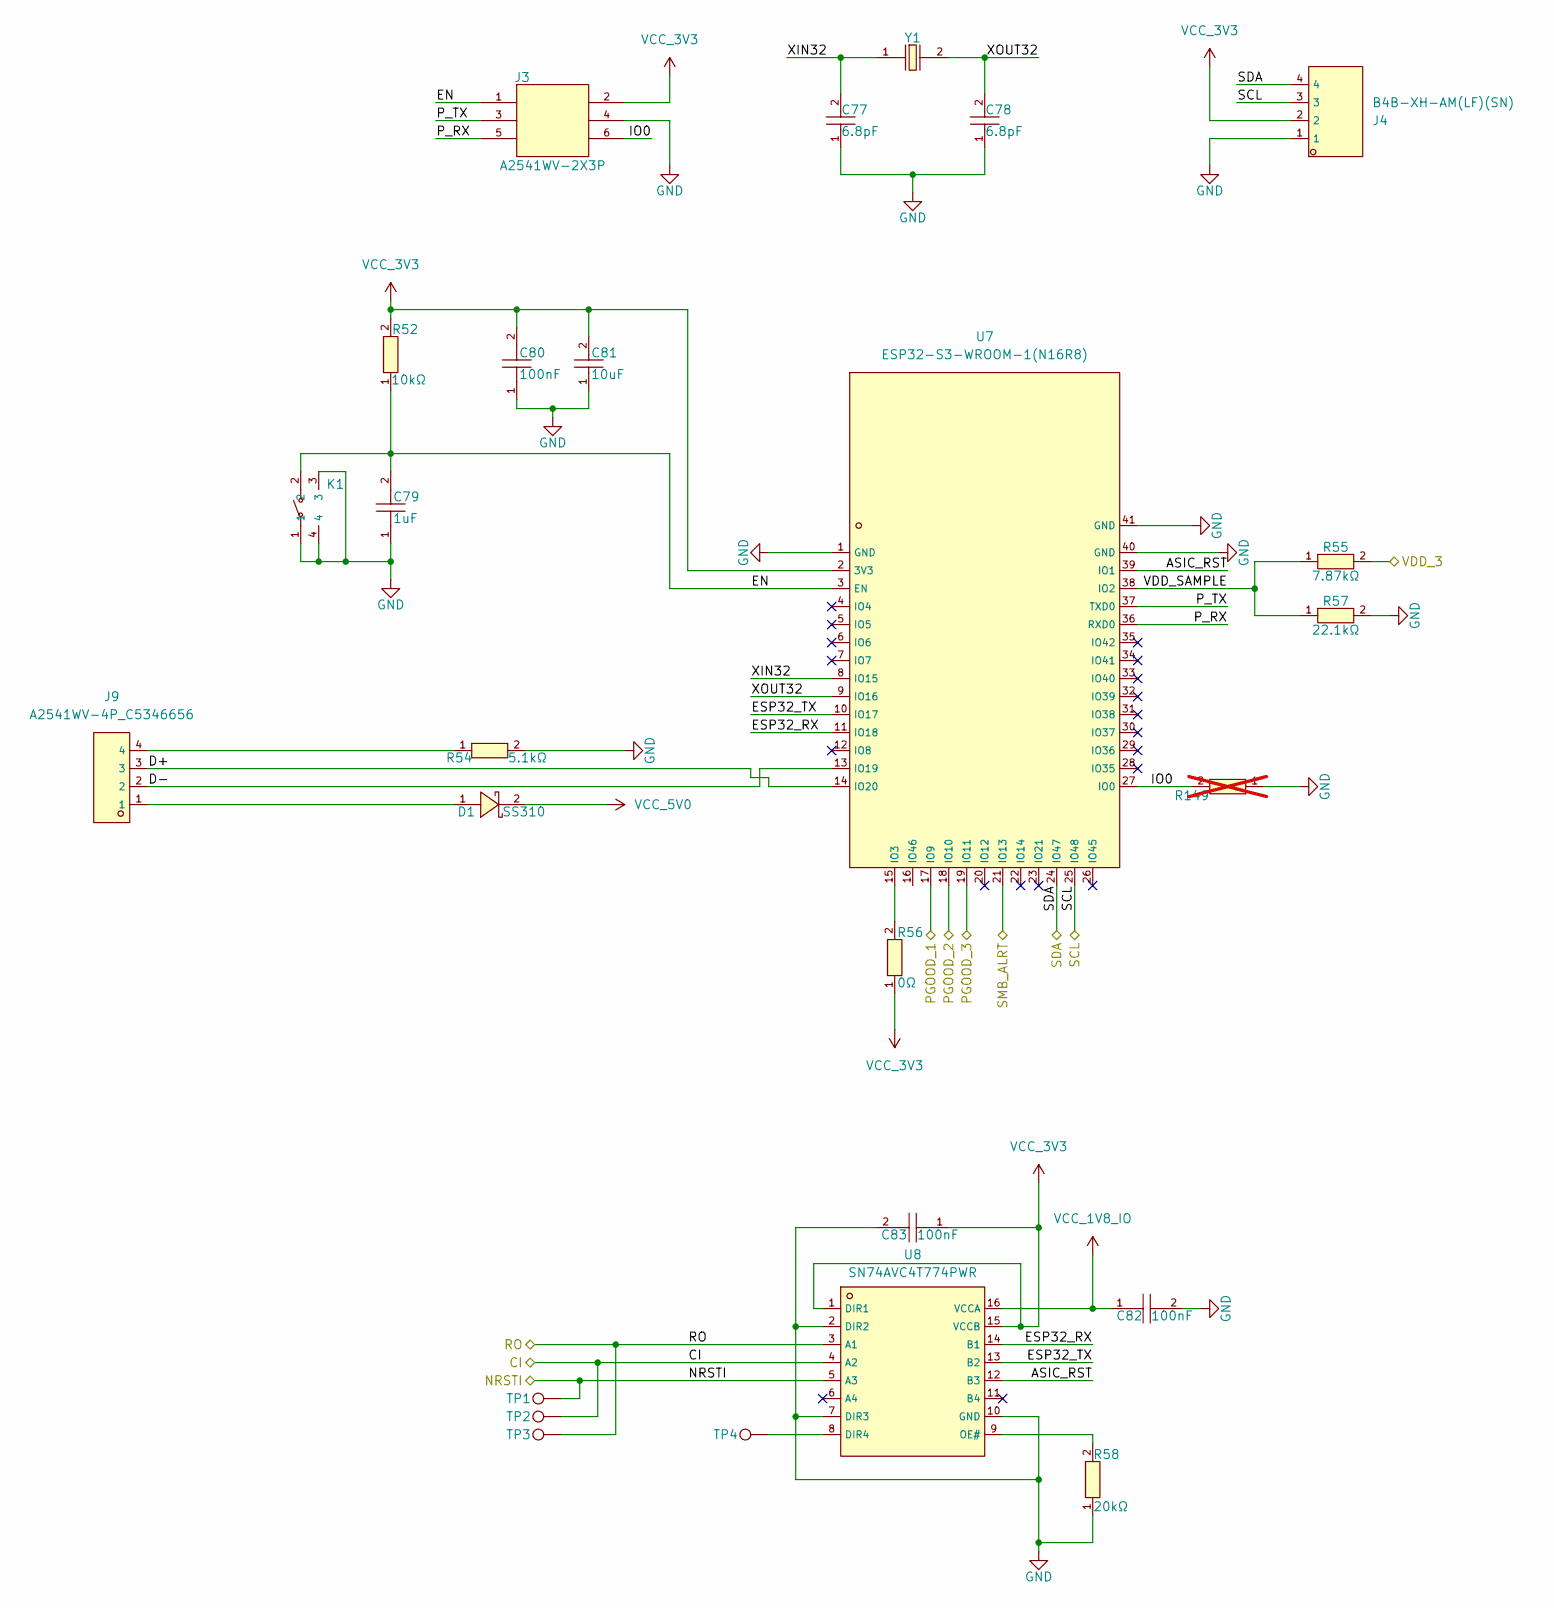
[picture p9: schematic ESP32.kicad_sch]

Parts:
C77, C78: 6.8pF; C0402; LCSC C1576
C79: 1uF; C0402; LCSC C52923
C80, C82, C83: 100nF; C0402; LCSC C307331
C81: 10uF; C0402; LCSC C15525
D1: SS310; SMA_L4.3-W2.6-LS5.0-FD; LCSC C7420364
J3: A2541WV-2X3P; HDR-TH_6P-P2.54-V-R2-C3-S2.54_A2541WV-2X3P; LCSC C225518
J4: B4B-XH-AM(LF)(SN); CONN-TH_B4B-XH-AM-LF-SN; LCSC C161871
J9: A2541WV-4P_C5346656; HDR-TH_4P-P2.54-V-M; LCSC C5346656
K1: K2-1102AQ-C4CW-01; SW-TH_K2-1102AQ-C4CW-01; LCSC C127680
R52: 10kΩ; R0402; LCSC C25744
R54: 5.1kΩ; R0402; LCSC C25905
R55: 7.87kΩ; R0402; LCSC C11520
R56: 0Ω; R0402; LCSC C17168
R57: 22.1kΩ; R0402; LCSC C43473
R58: 20kΩ; R0402; LCSC C25765
R149: 0Ω; R0402; LCSC C17168; not fitted
TP1, TP2, TP3, TP4: TestPoint; TestPoint_Pad_D1.0mm
U7: ESP32-S3-WROOM-1(N16R8); WIRELM-SMD_ESP32-S3-WROOM-1; LCSC C2913202
U8: SN74AVC4T774PWR; TSSOP-16_L5.0-W4.4-P0.65-LS6.4-BL; LCSC C129363
Y1: SC-20S32_768kHz20PPM7pF; OSC-SMD_L2.0-W1.2; LCSC C97602

Connections:
ASIC_RST: U7.39 (IO1), U8.12 (B3)
CI: TP2.1, U8.4 (A2)
D+: J9.3, U7.14 (IO20)
D-: J9.2, U7.13 (IO19)
EN: C79.2, J3.1, K1.2, R52.1, U7.3 (EN)
ESP32_RX: U7.11 (IO18), U8.14 (B1)
ESP32_TX: U7.10 (IO17), U8.13 (B2)
GND: C77.1, C78.1, C79.1, C80.1, C81.1, C82.2, C83.2, J3.4, J4.1, K1.1, K1.3, K1.4, R54.2, R57.2, R58.1, R149.1, U7.1 (GND), U7.40 (GND), U7.41 (GND), U8.2 (DIR2), U8.7 (DIR3), U8.10 (GND)
IO0: J3.6, R149.2, U7.27 (IO0)
NRSTI: TP1.1, U8.5 (A3)
unnamed: D1.1 (A), J9.1
unnamed: J9.4, R54.1
unnamed: R56.2, U7.15 (IO3)
unnamed: R58.2, U8.9 (OE#)
unnamed: TP4.1, U8.8 (DIR4)
PGOOD_1: U7.17 (IO9)
PGOOD_2: U7.18 (IO10)
PGOOD_3: U7.19 (IO11)
P_RX: J3.5, U7.36 (RXD0)
P_TX: J3.3, U7.37 (TXD0)
RO: TP3.1, U8.3 (A1)
SCL: J4.3, U7.25 (IO48)
SDA: J4.4, U7.24 (IO47)
SMB_ALRT: U7.21 (IO13)
VCC_1V8_IO: C82.1, U8.16 (VCCA)
VCC_3V3: C80.2, C81.2, C83.1, J3.2, J4.2, R52.2, R56.1, U7.2 (3V3), U8.1 (DIR1), U8.15 (VCCB)
VCC_5V0: D1.2 (K)
VDD_3: R55.2
VDD_SAMPLE: R55.1, R57.1, U7.38 (IO2)
XIN32: C77.2, U7.8 (IO15), Y1.1
XOUT32: C78.2, U7.9 (IO16), Y1.2
