Luckst4r/OpenSourcedMiners/LuckyMinerLV08/Sensors_Modules.kicad_sch

## KiCad design LuckyMinerLV08/Sensors_Modules.kicad_sch (2025-10-28)

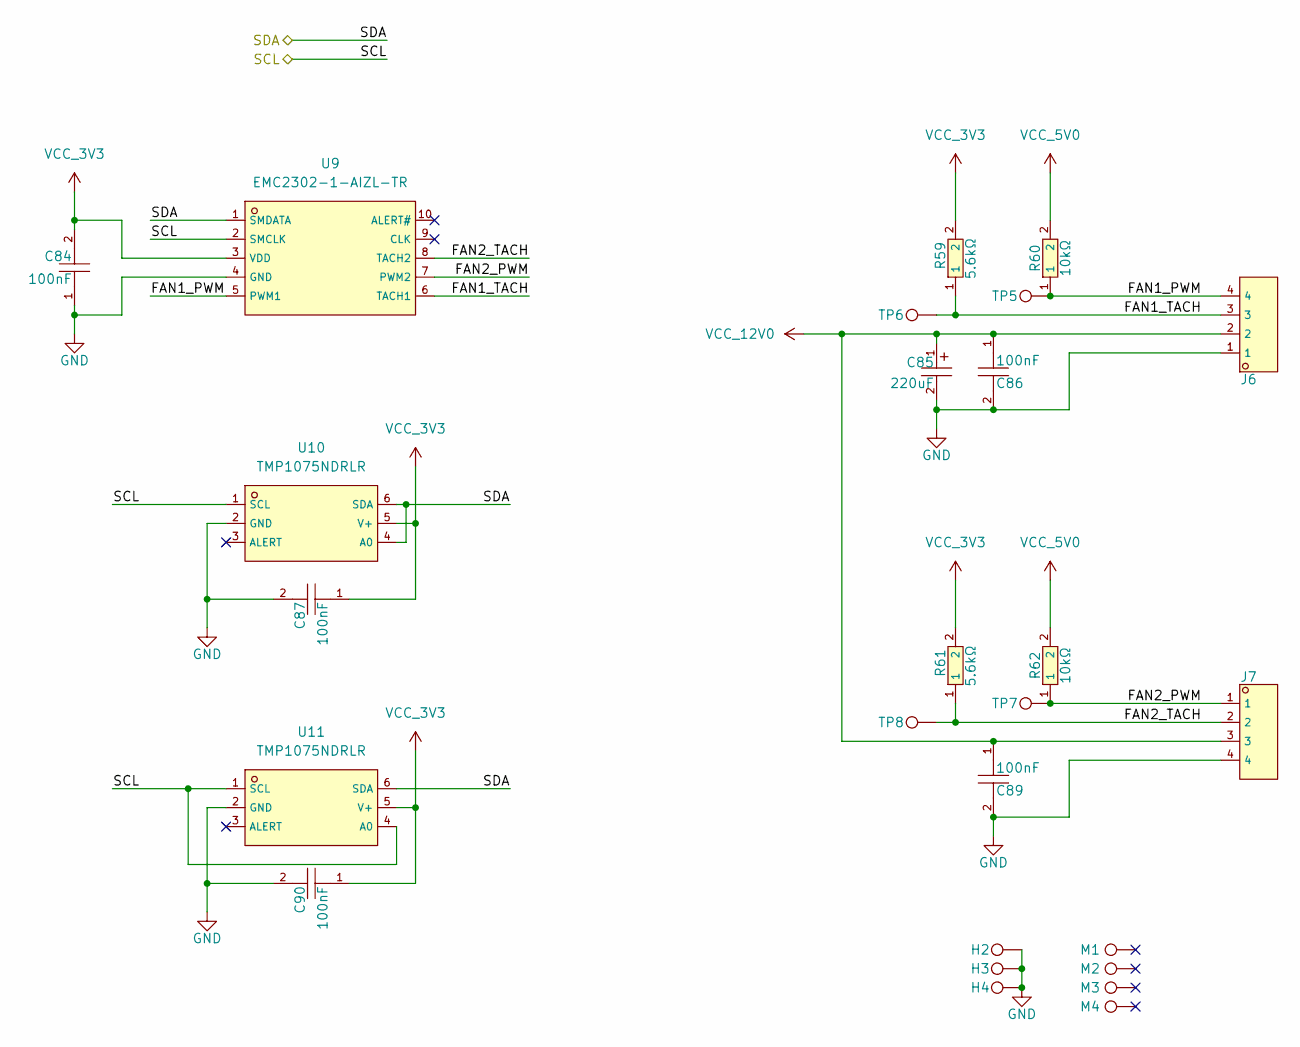
[picture p10: schematic Sensors_Modules.kicad_sch]

Parts:
C84, C86, C87, C89, C90: 100nF; C0402; LCSC C307331
C85: 220uF; CAP-SMD_BD6.3-L6.6-W6.6-FD; LCSC C3342
H2, H3, H4: TestPoint; MountingHole_2.2mm_M2_DIN965_Pad
J6, J7: 22-11-2042; CONN-TH_22112042; LCSC C114123
M1, M2, M3, M4: TestPoint; TestPoint_Loop_D3.80mm_Drill2.0mm
R59, R61: 5.6kΩ; R0402; LCSC C25908
R60, R62: 10kΩ; R0402; LCSC C25744
TP5, TP6, TP7, TP8: TestPoint; TestPoint_Pad_D1.0mm
U9: EMC2302-1-AIZL-TR; MSOP-10_L3.0-W3.0-P0.50-LS4.9-BL; LCSC C626969
U10, U11: TMP1075NDRLR; SOT-563_L1.6-W1.2-P0.50-LS1.6-BR; LCSC C3663690

Connections:
FAN1_PWM: J6.4, R60.1, TP5.1, U9.5 (PWM1)
FAN1_TACH: J6.3, R59.1, TP6.1, U9.6 (TACH1)
FAN2_PWM: J7.1, R62.1, TP7.1, U9.7 (PWM2)
FAN2_TACH: J7.2, R61.1, TP8.1, U9.8 (TACH2)
GND: C84.1, C85.2, C86.2, C87.2, C89.2, C90.2, H2.1, H3.1, H4.1, J6.1, J7.4, U9.4 (GND), U10.2 (GND), U11.2 (GND)
SCL: U9.2 (SMCLK), U10.1 (SCL), U11.1 (SCL), U11.4 (A0)
SDA: U9.1 (SMDATA), U10.4 (A0), U10.6 (SDA), U11.6 (SDA)
VCC_3V3: C84.2, C87.1, C90.1, R59.2, R61.2, U9.3 (VDD), U10.5 (V+), U11.5 (V+)
VCC_5V0: R60.2, R62.2
VCC_12V0: C85.1, C86.1, C89.1, J6.2, J7.3
