Luckst4r/OpenSourcedMiners/(commit log)

2025-10-28 LuckyMiner LV08 Files Upload
    [BM1366_mode1_sheet_1.kicad_sch, BM1366_mode1_sheet_2.kicad_sch, BM1366_mode1_sheet_3.kicad_sch, Buck_Converters_TPS546D24ARVFR.kicad_sch, ESP32.kicad_sch, LV08.csv, LV08.kicad_sch, Sensors_Modules.kicad_sch]
2025-10-28 Add Gerbers
    [LV08-B_Cu.gbr, LV08-B_Mask.gbr, LV08-B_Paste.gbr, LV08-B_Silkscreen.gbr, LV08-Edge_Cuts.gbr, LV08-F_Cu.gbr, LV08-F_Mask.gbr, LV08-F_Paste.gbr]
2025-10-28 KiCad Library
2025-10-28 FootprintLib for KiCad
2025-10-29 JLCPCB CPL file upload
    [CPL-LV08.xlsx]
